TillF/SDI-logger/(threads)

Thread 1 (2019-05-17):

Revise sleep mode

TillF, 2019-05-17:
Still not working reliably:
- sometimes, the voltage of the wakeup-pins seems not to be high before falling asleep
- sometimes, the voltage drops but the interrupt does not fire (neither with FALLING, LOW, CHANGE)

TillF, 2019-12-01:
Should be fixed, but I'll leave this open to be sure...

Closed 2021-03-05.

Thread 2 (2019-11-29):

Detect card error during operation

TillF, 2019-11-29:
Currently, removing the SD-card does not create an error

Closed 2019-12-01.

Thread 3 (2021-03-05):

Improve LED-messaging

TillF, 2021-03-05:
- longer delay after flicker codes
- introduce sleep mode code
- enhance "blink" routine

SophiaDobko, 2021-12-22:
- sometimes the measuring "blink" signal is not shown although data are recorded correctly

-> maybe this happens when there was a NA-reading before succesful reading?

Closed 2022-01-03.

Thread 4 (2021-12-22):

Deal with NA

SophiaDobko, 2021-12-22:
Go to sleep or to the next probe when there was an NA.
Currently, NA of one probe in the middle causes 30 tries at each measurement interval, maybe only NA in the beginning should cause these repeated readings to avoid losing too much energy with all the repeating.

Closed 2021-12-30.

Thread 5 (2021-12-22):

Deal with SD-card error

SophiaDobko, 2021-12-22:
with the present version, power consumption increases when there is no SD-card or an SD-card error

TillF, 2022-01-02:
This issue is hard to reproduce:
When powered via USB, everything works as expected.
When powered with 11.8 V via Vin, things seem to depend on the used SD-card:
- 32 GB HC1 from SanDisk, FAT32: works as expected, 20 mA in sleep mode (Vboard = 4.93 V)
- 32 GB from Sony, FAT32: SD-card not found, ~ 40 mA in sleep mode (Vboard = 4.93 V)

Board-Voltage when powered via USB are slightly lower:
san: 4.56 / 4.73 V
sony: 4.7 / 4.75 V

Note: Current in sleep mode drops considerably when SD-card is removed, increases beyond initial value when re-inserted.

Summary:
Cannot be fixed now. Try to collect more information, when the error occurs.

SophiaDobko, 2022-01-03:
Hey Till,
War das nicht andersherum, dass bei fehlender SD-Karte der Stromverbrauch
höher war als mit und wir den Eindruck hatten der Arduino "schläft nicht
richtig ein" wenn die SD-Karte fehlt?
Ich wollte noch kurz nachfrage wegen unserer letzten Dienstreise, du
rechnest das Auto wahrscheinlich selber ab, oder? Dann müsste ich gar keine
Abrechnung machen diesmal.
Viele Grüße,
Sophia

On Sun, 02 Jan 2022 05:31:46 -0800
  TillF ***@***.***> wrote:
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

-------
Sophia Dobkowitz
Institut für Umweltwissenschaften und Geographie
Lehrstuhl Hydrologie und Klimatologie
Universität Potsdam
Karl-Liebknecht-Str. 24-25
14476 Potsdam-Golm
+49 331 977 2254

Thread 6 (2022-04-22):

deal with single failing sensors

SophiaDobko, 2022-04-22:
When there is a problem with a single sensor, it shouldn't be tried to many times because otherwise the other sensores also can't measure

TillF, 2022-04-25:
I don't get the point.
The number of tries and the intermediate waiting time can both be adjusted in the settings, so this can be customized.
Warum können dann die anderen Sensoren nicht messen? Dauert nur etwas länger, oder?

SophiaDobko, 2022-04-25:
Ich weiß auch nicht. Hab das Thema aufgemacht da du so was in der Art im
Protokoll notiert hattest.

On So, 24 Apr 2022 23:47:41 -0700
  TillF ***@***.***> wrote:
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

-------
Sophia Dobkowitz
Institut für Umweltwissenschaften und Geographie
Lehrstuhl Hydrologie und Klimatologie
Universität Potsdam
Karl-Liebknecht-Str. 24-25
14476 Potsdam-Golm
+49 331 977 2254

SophiaDobko, 2022-05-24:
For + and data the problem is solved.
For GND one single disconnected cable still produces NA for all sensor.
Possible fix: use different data pins, so that not all sensors will be concerned. Requires skript adaptation.

Thread 7 (2022-11-18):

Problem with Library DS3231 version 1.1.0

SophiaDobko, 2022-11-18:
The SDI-logger skript uses the library DS3231 (https://github.com/NorthernWidget/DS3231) for the RTC.
With DS3231 Version 1.0.2 and 1.0.7 it works fine.
But with Version 1.1.0 the skript doesn't work. Instead, only the first record after starting the Arduino works, then it goes to sleep mode.
When the Arduino wakes up for any of the next measurements, there is a problem with the SD-card reportet:

```
Init SD card...ok.
SD-card write error
wait&sleep..
```
