TillF/SDI-logger/(commit log)

2019-03-21 added sleep option (still buggy)
    [SDI-logger.ino]
2019-03-24 FIX: faulty implementation of sleep/wakeup. Seems to work now.
    [SDI-logger.ino]
2019-03-27 ENH: - optional support of message LED (pin D3) - take immediate reading after power-up regardless of time (to check sensor, record power-up events)
2019-03-27 ENH: - log voltage to file
2019-04-10 ENH: include SDI-sensor-ID in header improve docu
2019-04-10 ENH: support of multiple SDI-sensors (not yet fully tested)
2019-05-16 FIX: fixed (?) sleep mode
    [SDI-logger.ino]
2019-05-17 FIX: more standby issues
    [SDI-logger.ino]
2019-05-22 FIX: corrected the default input pin for SDI
    [setup_sdi.ino]
2019-05-22 FIX: avaoid warning message for longer values of AWAKE_TIME
    [SDI-logger.ino]
2019-05-22 FIX: faulty output of newly-set time in set_clock.ino
    [set_clock.ino]
2019-06-05 FIX: disabled faulty retrieval of sensor serial ENH: parameters as used in JFC-1 campaign
    [SDI-logger.ino, setup_sdi.ino]
2019-08-23 ENH: - write SDI-IDs and script version to head of logger file - corrected some comments
    [SDI-logger.ino, setup_sdi.ino]
2019-12-01 FIX: - eliminated some Strings to save memory - fixed bug caused by inadverted multiple calls of interrupt, breaking the sleep mode
    [SDI-logger.ino]
2019-12-02 ENH: fire interrupt at LOW, not FALLING. Presumably increases robustness in case of RTC-failure
    [SDI-logger.ino]
2020-02-27 FIX: disabled waiting for serial - caused hang with Pro Micro - updated README.md
    [SDI-logger.ino, setup_sdi.ino]
2020-07-02 ENH: corrected code comments
    [SDI-logger.ino]
2020-07-03 ENH: - tidied up code - increase blink frequency - ensured LED is off - imporved power switching for sensors
2020-07-08 FIX/ENH: earlier sensor power on, streamlined console output, fixed typos
    [SDI-logger.ino, setup_general.h, setup_sdi.h]
2020-10-01 - light message LED during reading sensors - eliminate warning during compilation (string length) - enhanced power consumption numbers to docu
2021-02-09 Added counting of NA-readings from sensor and automatic increase of waiting time
2021-02-16 amended prior commit; removed waiting time after reading replaced ; with Tab in SDI-ID strings
    [SDI-logger.ino, setup_general.h, setup_sdi.h]
2021-03-01 - replaced increasing waiting times by total number of readings that are attempted. - relocated some misc functions into misc_functions.h
    [SDI-logger.ino, misc_functions.h, setup_general.h, setup_sdi.h]
2021-03-01 eliminated some compiler warnings. May have changed the behaviour when no SDI-sensors are found, check!
2021-03-03 remove bug introduced by previous commit (caused hang when sensors where absent)
    [SDI-logger.ino, setup_general.h, setup_sdi.h]
2021-03-09 fix: removed duplicated Tab after SDI-sensor ID
    [SDI-logger.ino, setup_sdi.h]
2021-03-09 fix problem with SMT-100 returns, that miss a separator when temperature is negative
    [setup_sdi.h]
2021-03-09 leave LED on during readin of SDI sensors
2021-12-02 power comsumption nano3
2021-12-30 fixed faulty behaviour when reading NA from sensors\ncloses #4
    [setup_general.h, setup_sdi.h]
2021-12-30 corrected number of repeatitions in error messages
    [SDI-logger.ino, misc_functions.h]
2022-01-02 improved LED-messaging codes (see section "message LED" in README.md for details)
    closes #3
2022-05-23 fix: when a sensor did not yield results, its header and NA was not written to the log file
    [setup_sdi.h]
2022-06-03 FIXED severe bug introduced in 1.37: power pin was not activated, only very first reading succeeded.
    [SDI-logger.ino, setup_sdi.h]
